Juan-Gg/Linear-lab-bench-power-supply/README.md

# Linear-lab-bench-power-supply
This is a dual channel linear lab power supply, each channel capable of 30 V at 500 mA.
More information here: https://juangg-projects.blogspot.com/2019/05/linear-lab-power-supply.html
