Juan-Gg/Linear-lab-bench-power-supply/Mechanical/PSU Render.JPG

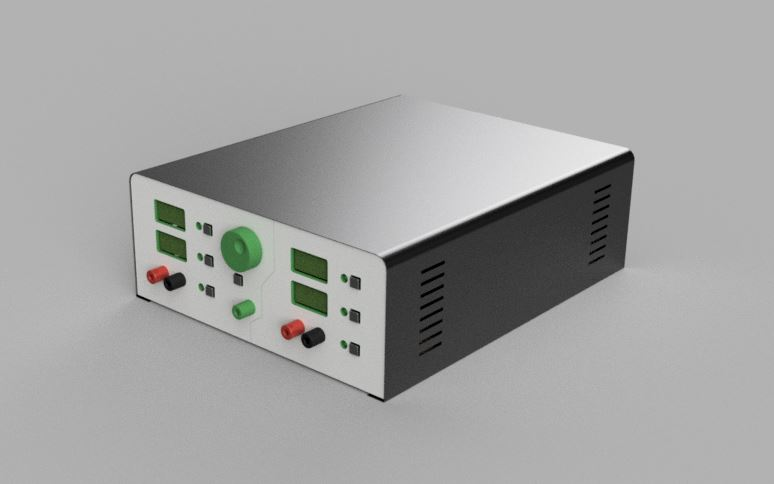
Mechanical/PSU Render.JPG
