Juan-Gg/Linear-lab-bench-power-supply/Mechanical/STLS/back_right.stl

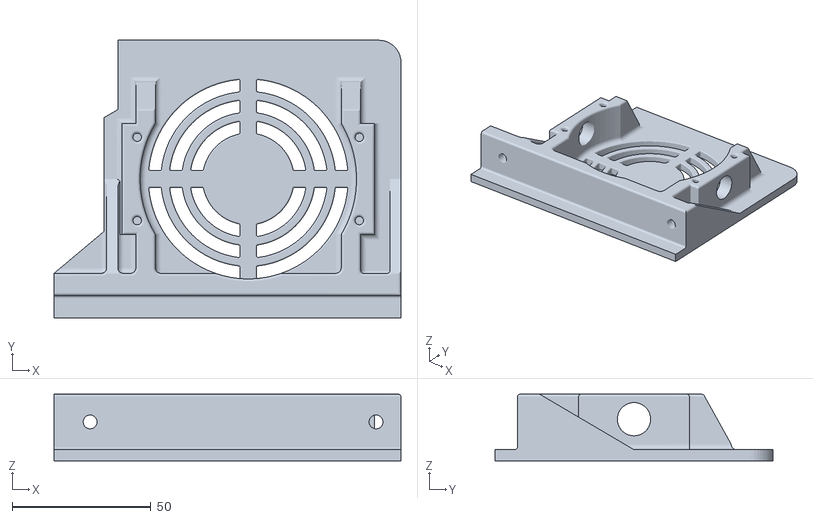
[picture p2: CAD file, 2019-05-11]
Mechanical/STLS/back_right.stl
125.0 x 100.0 x 24.0
