Juan-Gg/Linear-lab-bench-power-supply/Mechanical/STLS/knob.stl

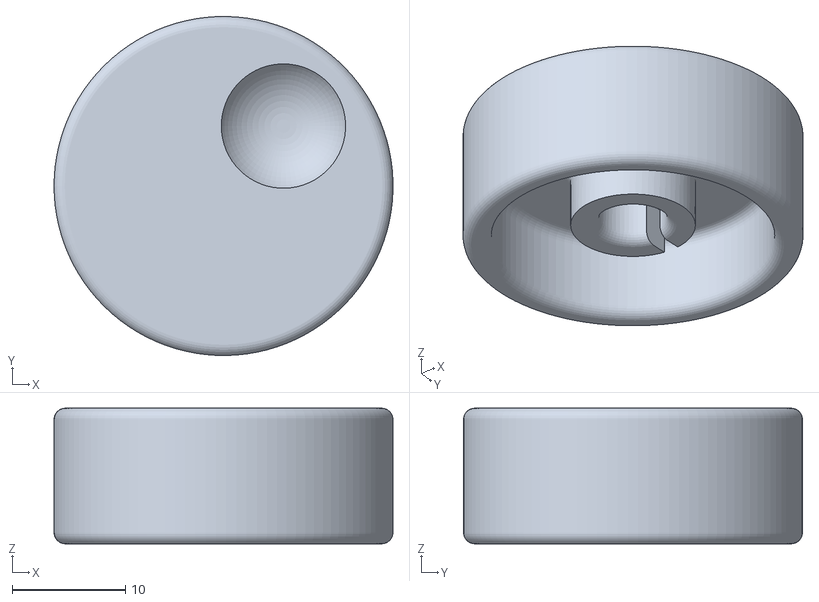
[picture p3: CAD file, 2019-05-11]
Mechanical/STLS/knob.stl
30.0 x 30.0 x 12.0
