Juan-Gg/Linear-lab-bench-power-supply/Mechanical/STLS/front_left.stl

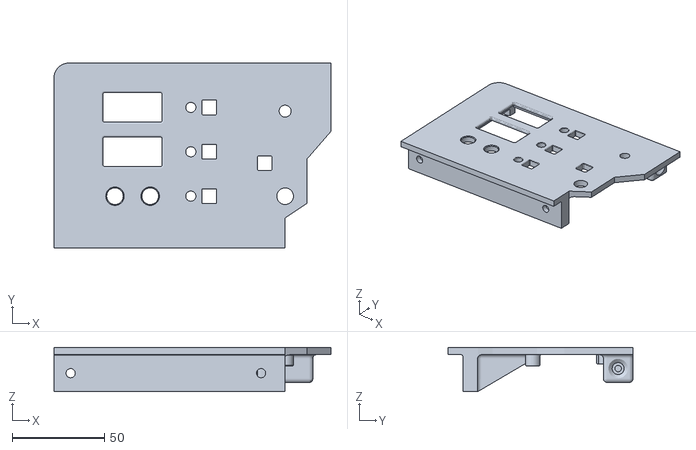
[picture p4: CAD file, 2019-05-11]
Mechanical/STLS/front_left.stl
149.8 x 100.0 x 24.0
