Juan-Gg/Linear-lab-bench-power-supply/Mechanical/STLS/back_left.stl

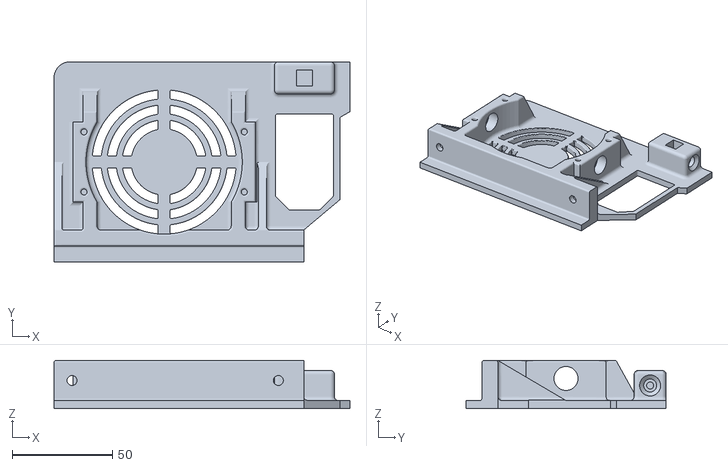
[picture p5: CAD file, 2019-05-11]
Mechanical/STLS/back_left.stl
147.8 x 100.0 x 24.0
