Juan-Gg/Linear-lab-bench-power-supply/Mechanical/STLS/btn.stl

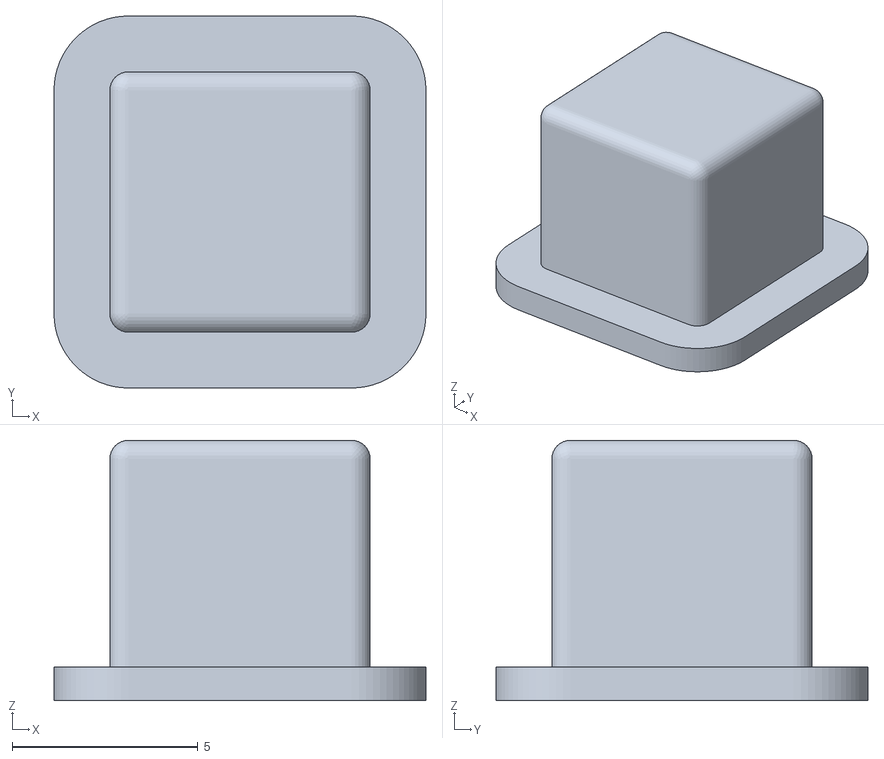
[picture p6: CAD file, 2019-05-11]
Mechanical/STLS/btn.stl
10.0 x 10.0 x 7.00
