Juan-Gg/Linear-lab-bench-power-supply/Mechanical/STLS/front_right.stl

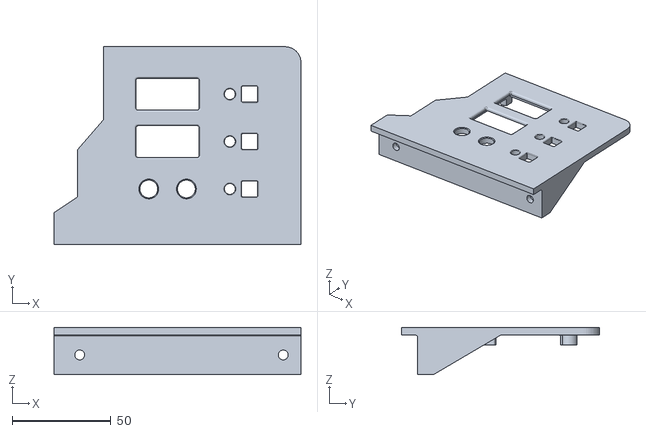
[picture p7: CAD file, 2019-05-11]
Mechanical/STLS/front_right.stl
125.0 x 100.0 x 24.0
