Juan-Gg/Linear-lab-bench-power-supply/Mechanical/STLS/PCB_mount.stl

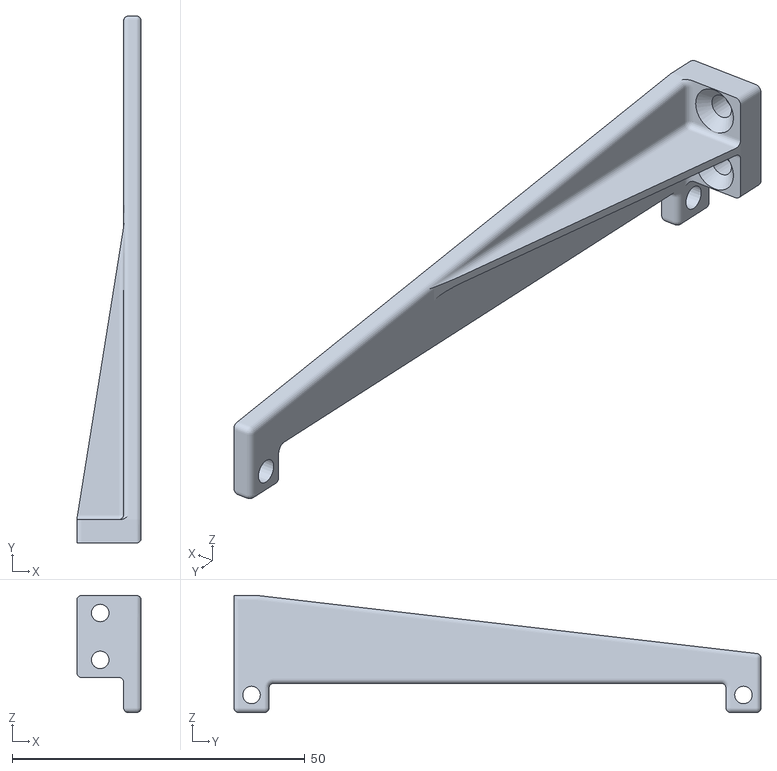
[picture p8: CAD file, 2019-05-11]
Mechanical/STLS/PCB_mount.stl
11.0 x 90.0 x 20.0
