Juan-Gg/Linear-lab-bench-power-supply/Electronics/RevBSchematics.pdf

## Q4 TIP35C

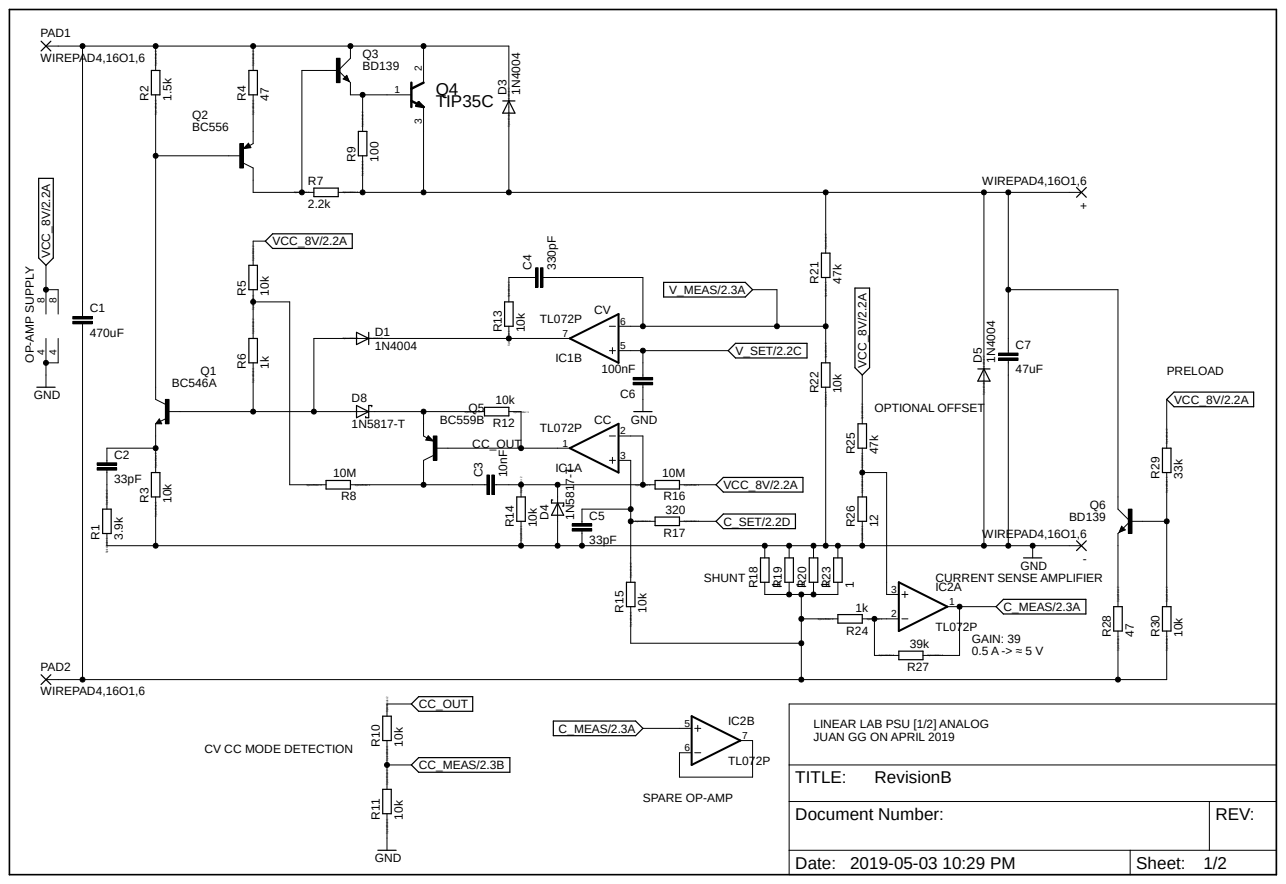
[picture p9: page 1]

CV CC MODE DETECTION OP⁻AMP SUPPLY

LINEAR LAB PSU [1/2] ANALOG
JUAN GG ON APRIL 2019

Document Number: | REV:

Date: 2019-05-03 10:29 PM | Sheet: 1/2

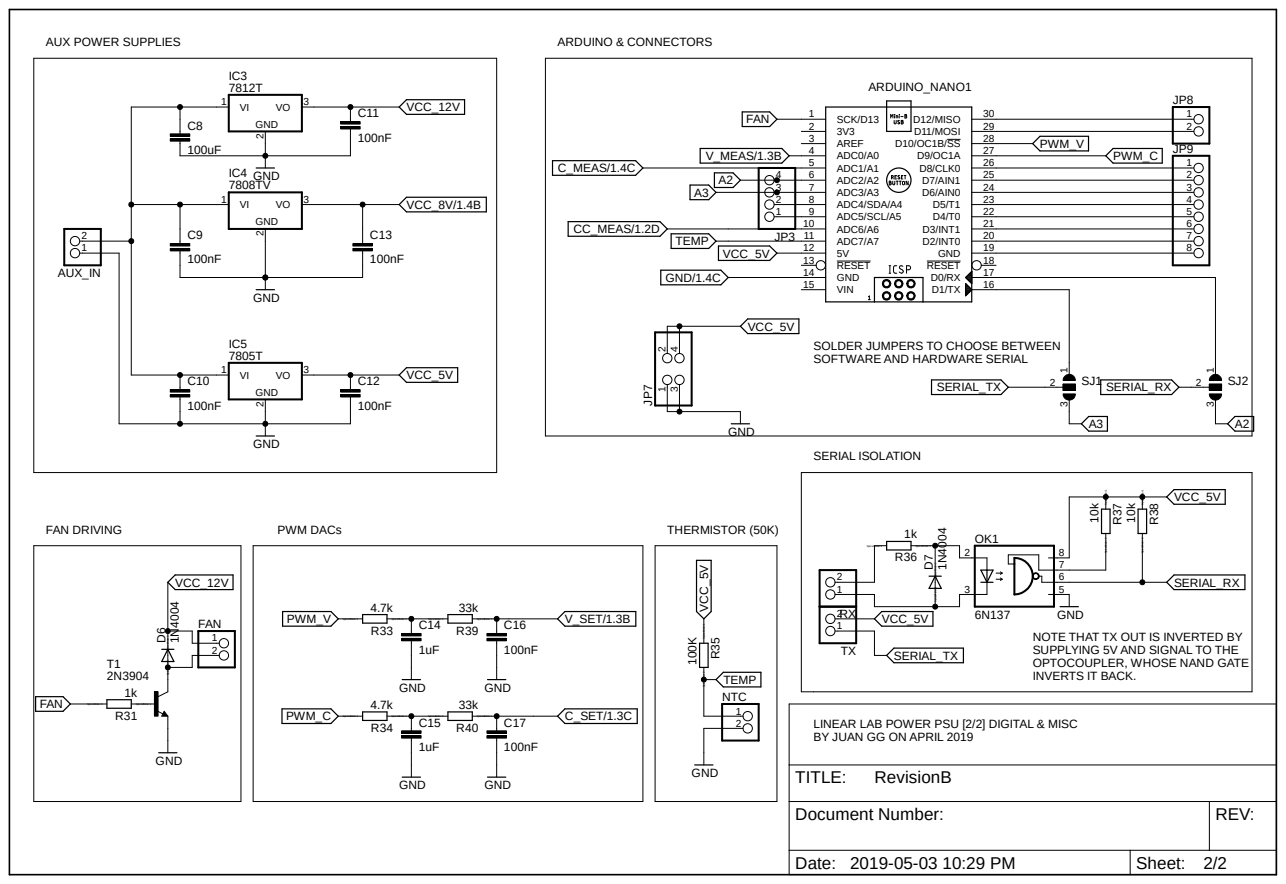
[picture p10: page 2]

ADC2/A2 6
3 | ADC3/A3 7

SOLDER JUMPERS TO CHOOSE BETWEEN
SOFTWARE AND HARDWARE SERIAL

NOTE THAT TX OUT IS INVERTED BY
SUPPLYING 5V AND SIGNAL TO THE
OPTOCOUPLER, WHOSE NAND GATE
INVERTS IT BACK.

LINEAR LAB POWER PSU [2/2] DIGITAL & MISC
BY JUAN GG ON APRIL 2019

Document Number: | REV:

Date: 2019-05-03 10:29 PM | Sheet: 2/2
