Juan-Gg/Linear-lab-bench-power-supply/Mechanical/Front panel overlay.pdf

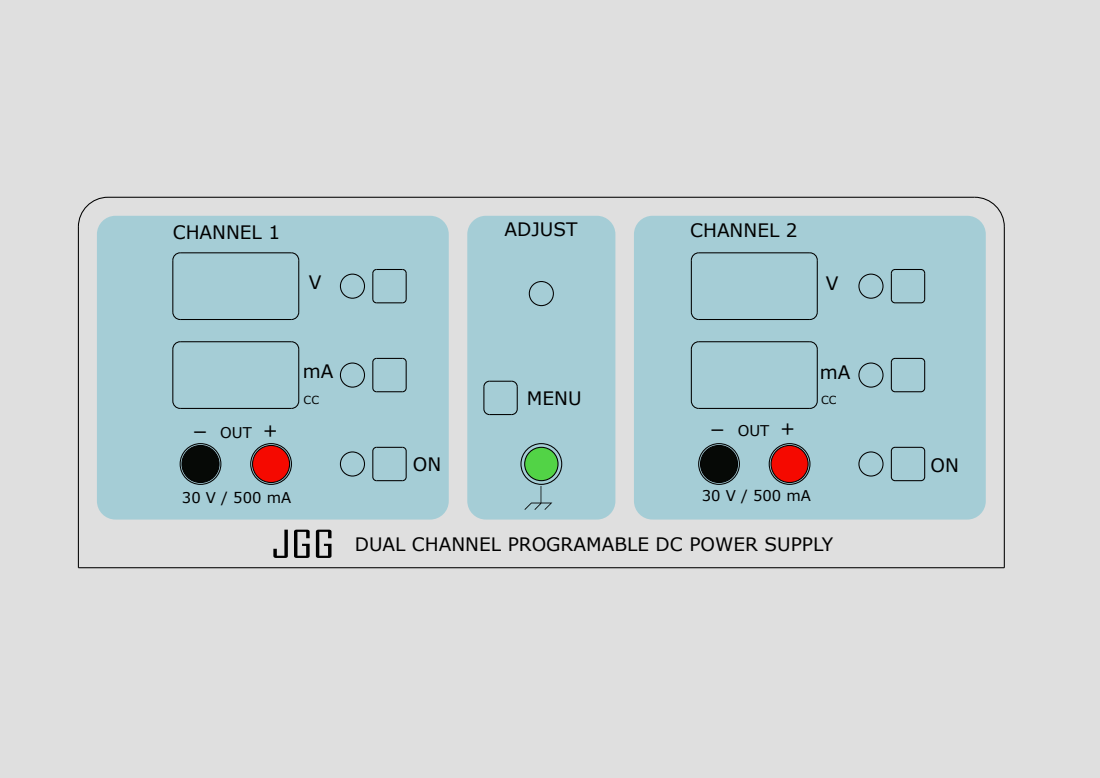
[picture p11: page 1]
CHANNEL 1; ADJUST; CHANNEL 2; OUT; MENU

JGG DUAL CHANNEL PROGRAMABLE DC POWER SUPPLY
