Juan-Gg/Linear-lab-bench-power-supply/Electronics/KeyboardSchematics.pdf

SLAVE (CH 1) | MASTER (CH 2)

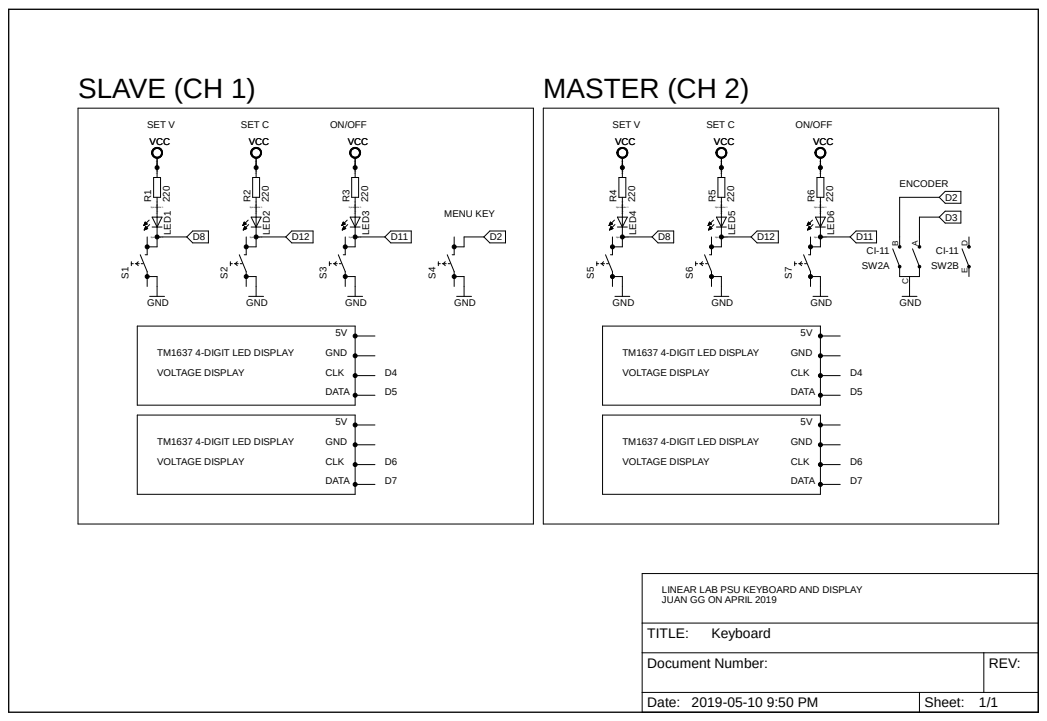
[picture p12: page 1]

LINEAR LAB PSU KEYBOARD AND DISPLAY
JUAN GG ON APRIL 2019

Document Number: | REV:

Date: 2019-05-10 9:50 PM | Sheet: 1/1
