Juan-Gg/Linear-lab-bench-power-supply/Electronics/RevABoardOverlay.pdf

+

# OUT

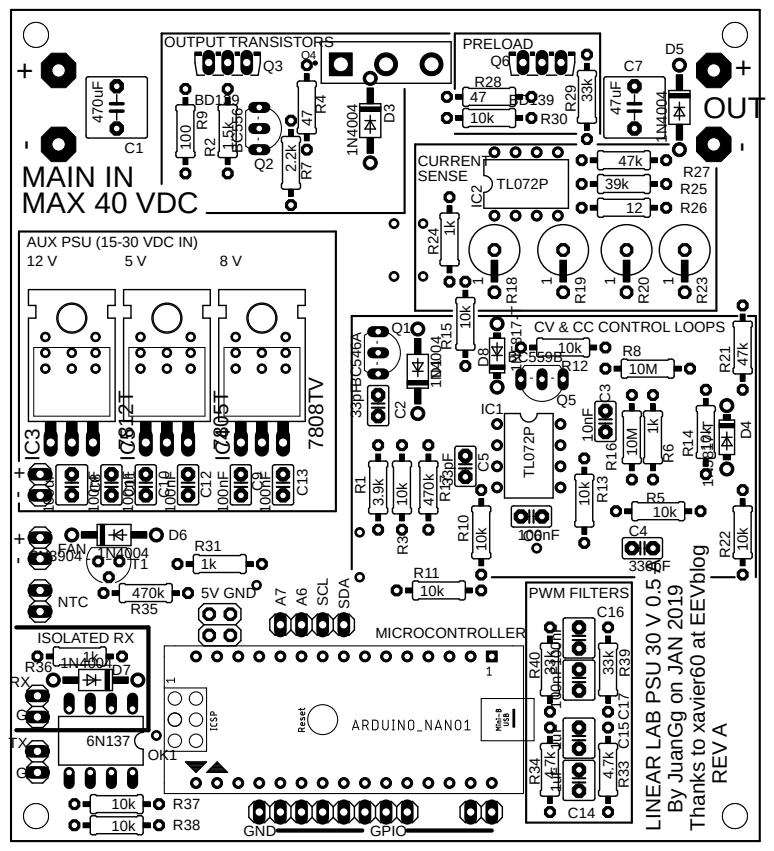
[picture p13: page 1]

OUTPUT TRANSISTORS
CV & CC CONTROL LOOPS LINEAR LAB PSU ³⁰ V ⁰.5 A By JuanGg on JAN ²⁰¹⁹ Thanks to xavier60 at EEVblog REV A

AUX PSU (15-30 VDC IN)
