Juan-Gg/Linear-lab-bench-power-supply/Electronics/RevASchematics.pdf

## Q4 TIP35C

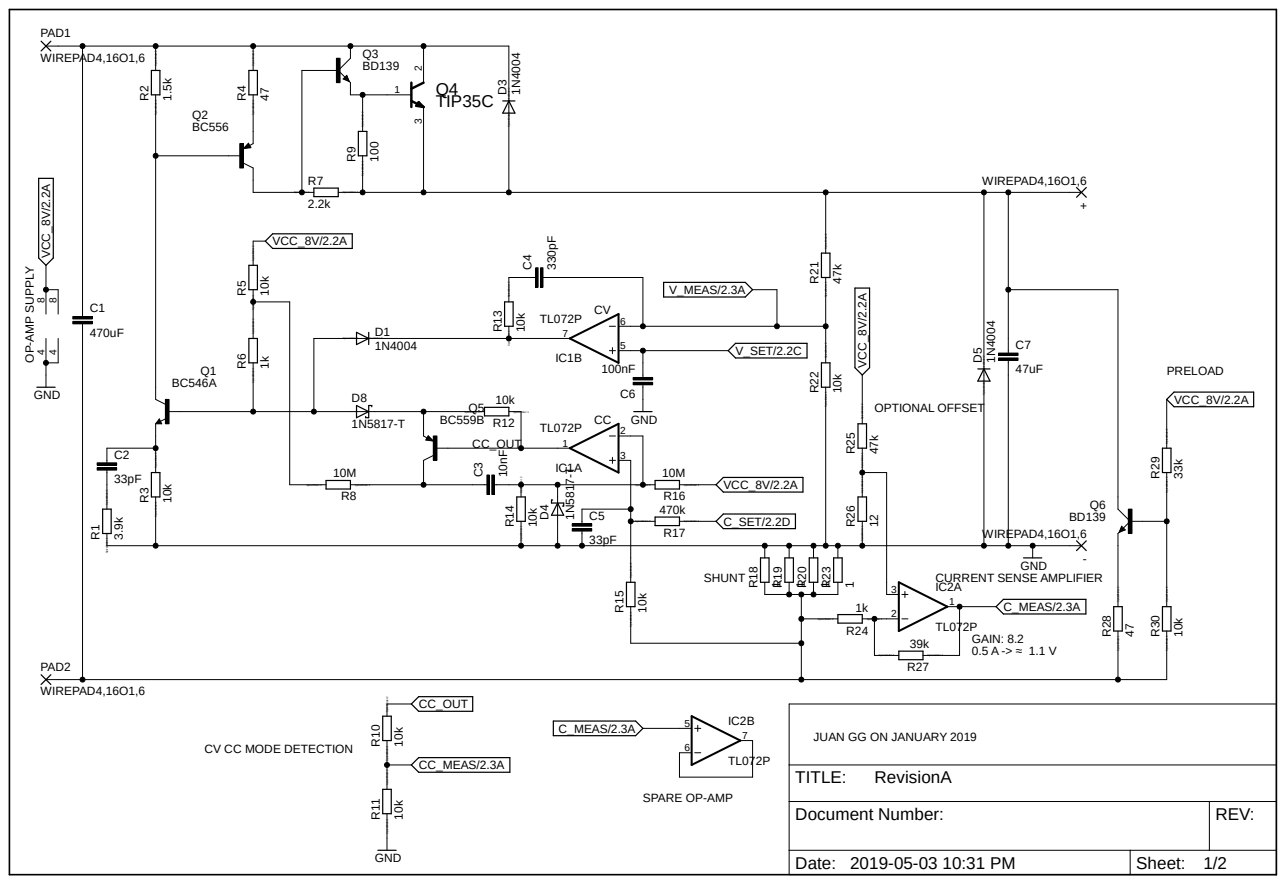
[picture p14: page 1]

CV CC MODE DETECTION OP⁻AMP SUPPLY

JUAN GG ON JANUARY 2019

Document Number: | REV:

Date: 2019-05-03 10:31 PM | Sheet: 1/2

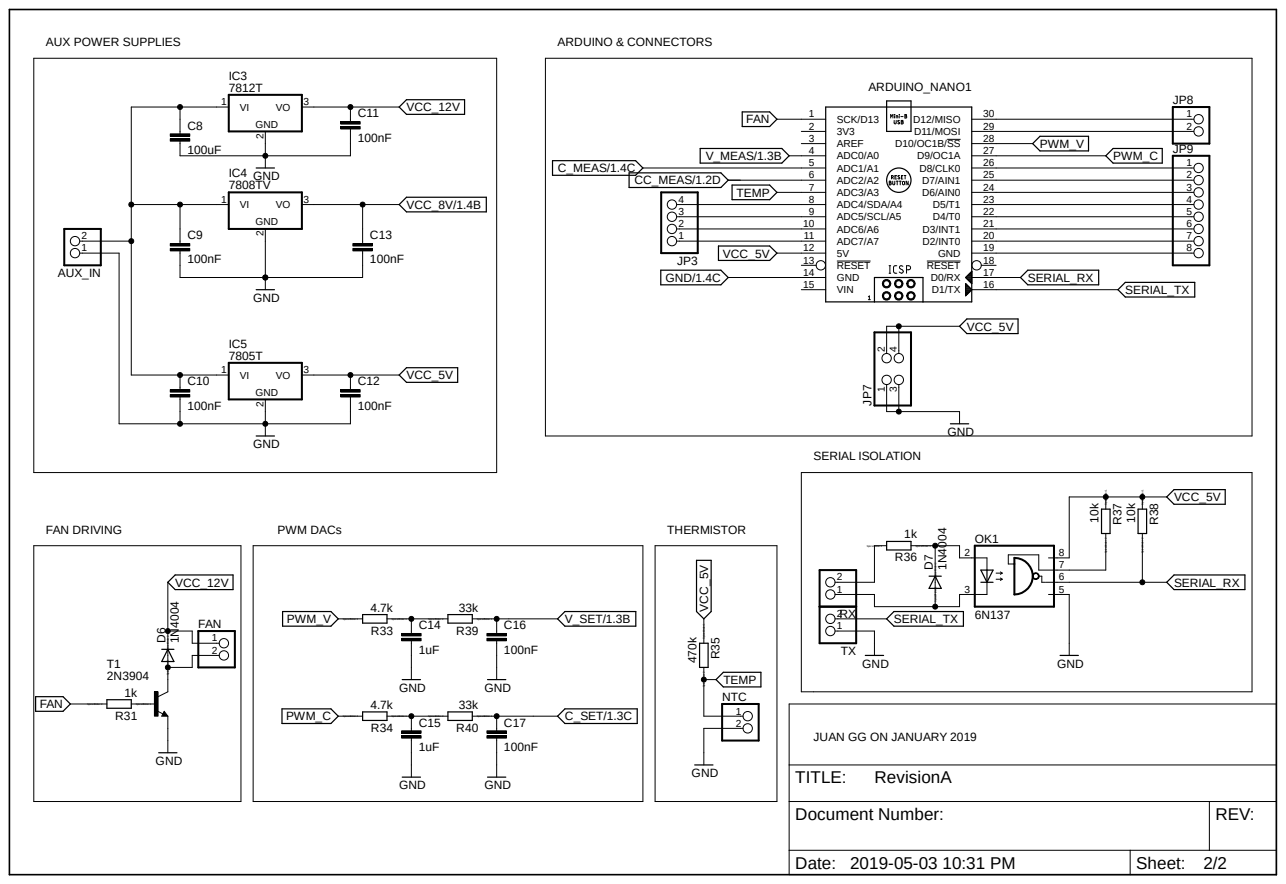
[picture p15: page 2]

JUAN GG ON JANUARY 2019

Document Number: | REV:

Date: 2019-05-03 10:31 PM | Sheet: 2/2
