Juan-Gg/Linear-lab-bench-power-supply/Electronics/RevBBoardOverlay.pdf

+

# OUT

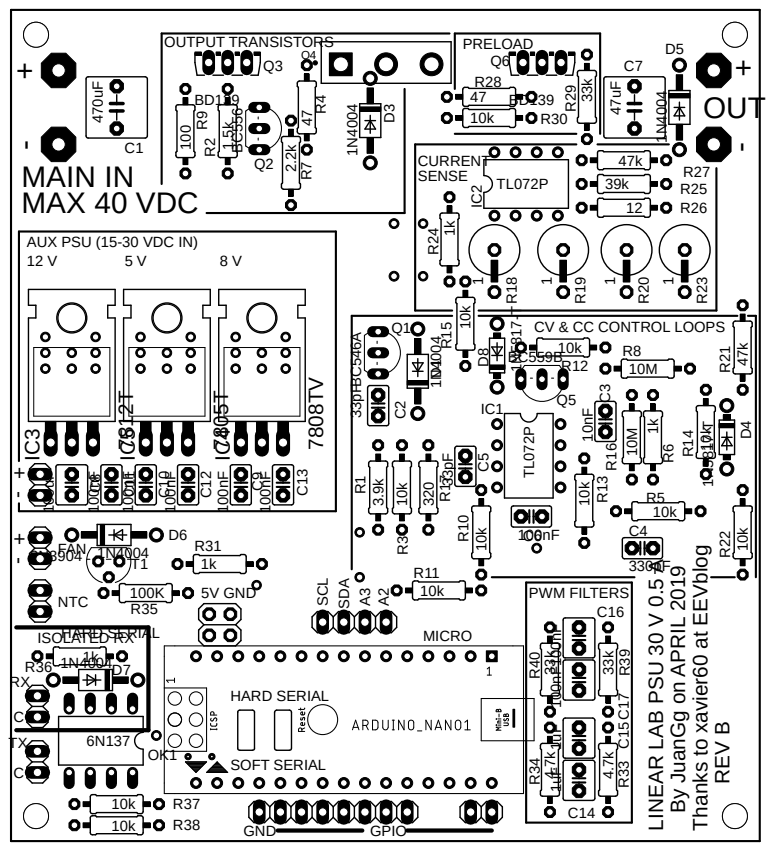
[picture p16: page 1]

AUX PSU (15-30 VDC IN)

CV & CC CONTROL LOOPS
