Juan-Gg/Linear-lab-bench-power-supply/Mechanical/Cover dimensions.pdf

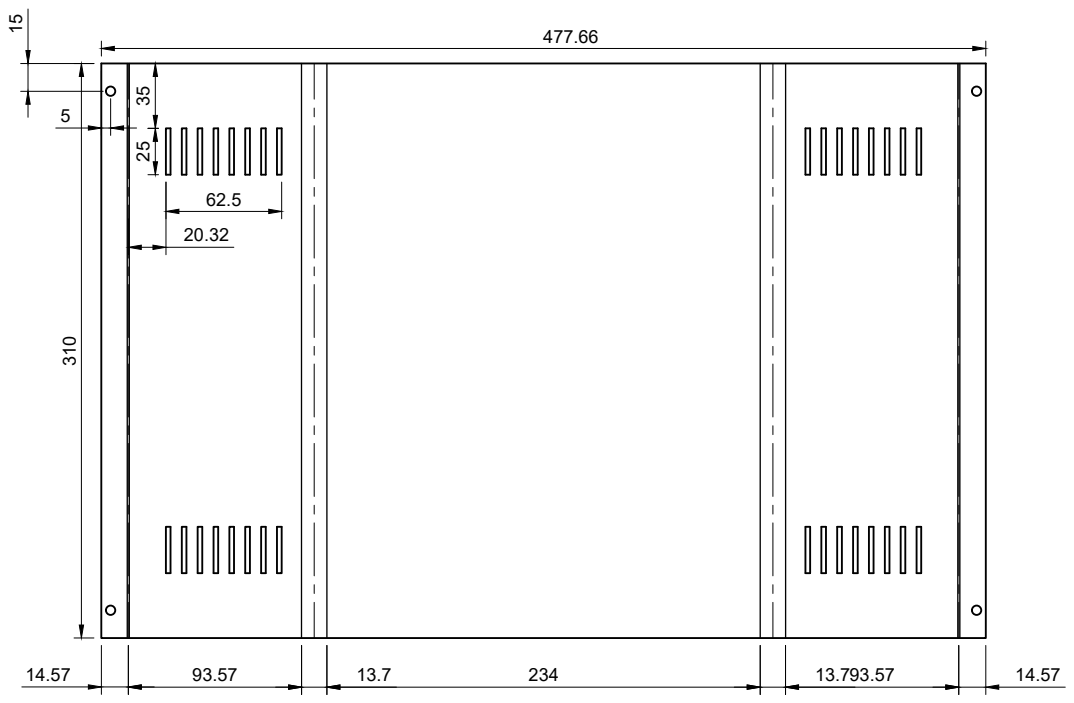
[picture p17: page 1]
