Juan-Gg/Linear-lab-bench-power-supply/Mechanical/Lab psu case drawing.pdf

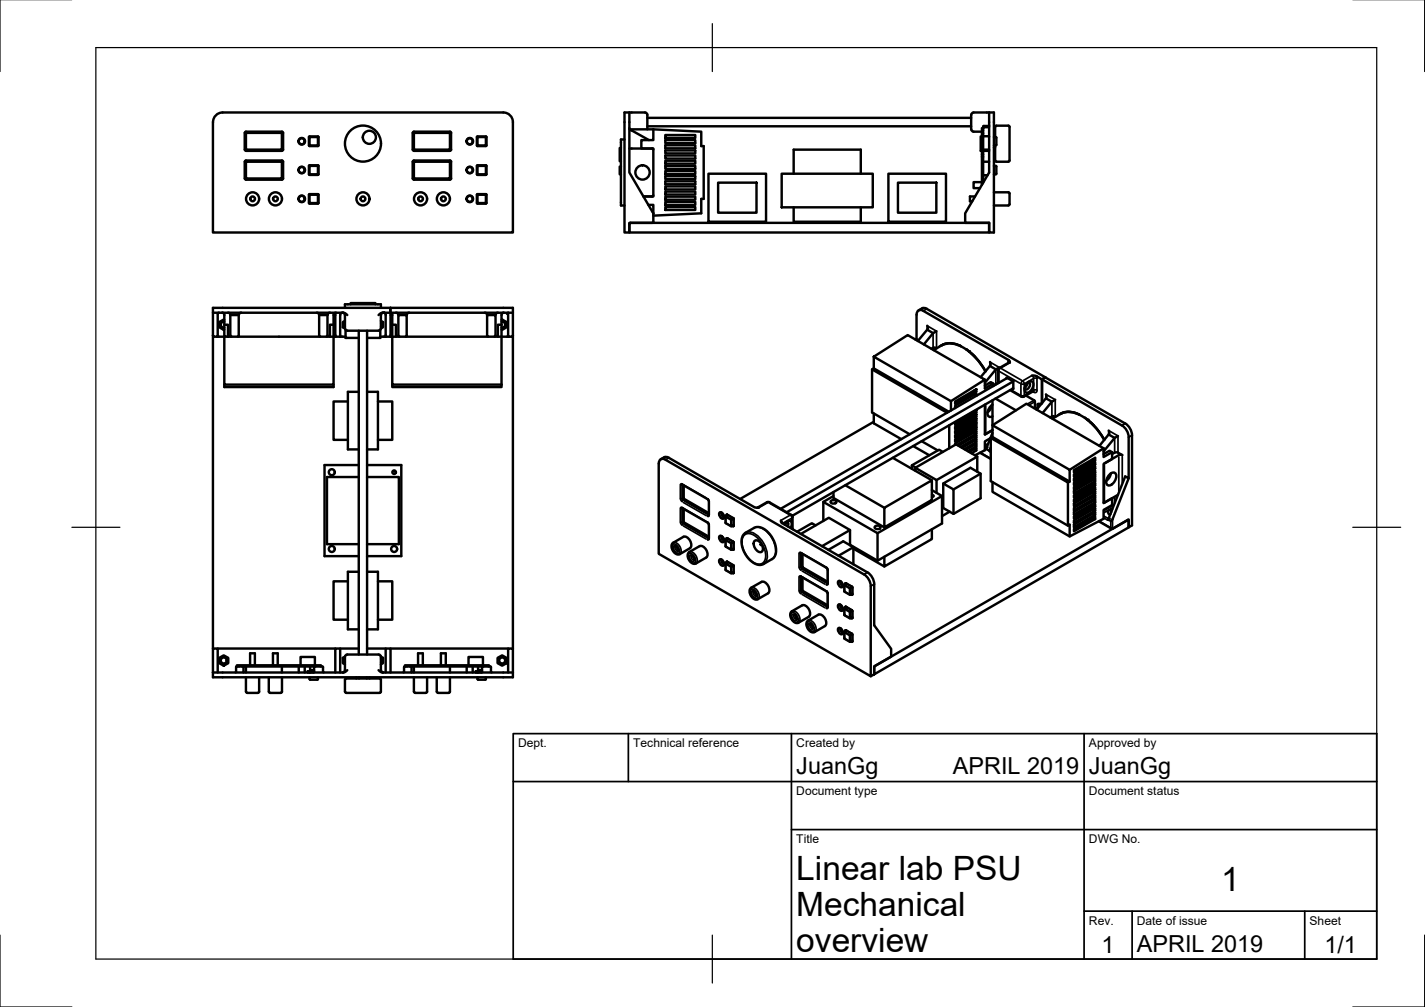
[picture p18: page 1]

Dept. | Technical reference | Created by JuanGg APRIL 2019 | Approved by JuanGg

Document type | Document status

Title Linear lab PSU Mechanical overview | DWG No. 1

Rev. 1 | Date of issue APRIL 2019 | Sheet 1/1
