Juan-Gg/Linear-lab-bench-power-supply/Electronics/RevisionA.brd

## EAGLE design Electronics/RevisionA.brd (2019-05-11, an earlier design)

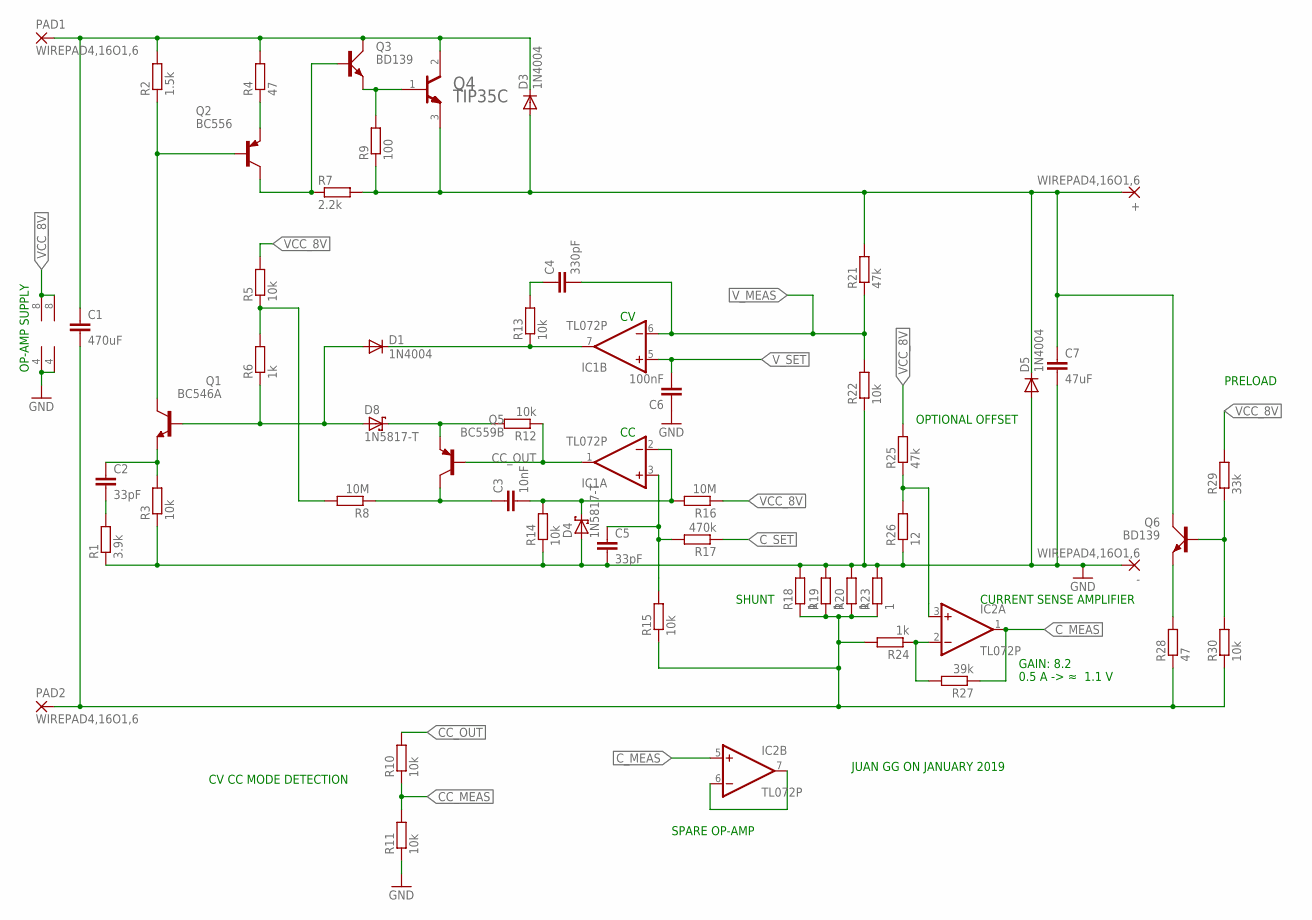
[picture p19: schematic RevisionA.sch, sheet 1]

Parts:
+: WIREPAD4,16O1,6; 4,16O1,6
-: WIREPAD4,16O1,6; 4,16O1,6
C1: 470uF; C5B7.2
C2, C5: 33pF; C2.5-2
C3: 10nF; C2.5-2
C4: 330pF; C2.5-2
C6: 100nF; C2.5-2
C7: 47uF; C5B7.2
D1, D3, D5: 1N4004; DO41-10
D4, D8: 1N5817-T; DO41-7.6
IC1, IC2: TL072P; DIL08
PAD1, PAD2: WIREPAD4,16O1,6; 4,16O1,6
Q1: BC546A; TO92-EBC
Q2: BC556; TO92-EBC
Q3, Q6: BD139; TO126AV
Q4: STMICROELECTRONICS_TIP35CSTMICROELECTRONICS_TIP35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; STMICROELECTRONICS_TIP35C_0
Q5: BC559B; TO92-EBC
R1: 3.9k; 0207/10
R2: 1.5k; 0207/10
R3, R5, R10, R11, R12, R13, R14, R15, R22, R30: 10k; 0207/10
R4, R28: 47; 0207/10
R6, R24: 1k; 0207/10
R7: 2.2k; 0207/10
R8, R16: 10M; 0207/10
R9: 100; 0207/10
R17: 470k; 0207/10
R18, R19, R20, R23: 1; 0617V
R21, R25: 47k; 0207/10
R26: 12; 0207/10
R27: 39k; 0207/10
R29: 33k; 0207/10

Connections:
+UNREG(MAIN): C1.1, D3.C, PAD1.1, Q3.C, Q4.2 (COLLECTOR), R2.2, R4.2
-UNREG(MAIN): C1.2, PAD2.1, R15.1, R18.1, R19.1, R20.1, R23.1, R24.2, R28.1, R30.1
CC_MEAS: R10.1, R11.2; also elsewhere on the board
CC_OUT: IC1.1 (OUT), Q5.B, R10.2, R12.1
C_MEAS: IC2.1 (OUT), IC2.5 (+IN), R27.1; also elsewhere on the board
C_SET: R17.1; also elsewhere on the board
GND: -.1, C5.2, C6.1, C7.2, D4.A, D5.A, IC1.4 (V-), IC2.4 (V-), R1.1, R3.1, R11.1, R14.1, R18.2, R19.2, R20.2, R22.1, R23.2, R26.1; also elsewhere on the board
unnamed: Q3.E, Q4.1 (BASE), R9.2
unnamed: +.1, C7.1, D3.A, D5.C, Q4.3 (EMITTER), Q6.C, R7.2, R9.1, R21.2
unnamed: Q2.C, Q3.B, R7.1
unnamed: Q2.E, R4.1
unnamed: Q1.C, Q2.B, R2.1
unnamed: R5.1, R6.2, R8.2
unnamed: D1.A, D8.A, Q1.B, R6.1
unnamed: C2.1, Q1.E, R3.2
unnamed: C2.2, R1.2
unnamed: D8.C, Q5.E, R12.2
unnamed: C3.2, D4.C, IC1.2 (-IN), R14.2, R16.2
unnamed: C3.1, Q5.C, R8.1
unnamed: C5.1, IC1.3 (+IN), R15.2, R17.2
unnamed: D1.C, IC1.7 (OUT), R13.1
unnamed: C4.1, R13.2
unnamed: Q6.E, R28.2
unnamed: Q6.B, R29.1, R30.2
unnamed: IC2.2 (-IN), R24.1, R27.2
unnamed: IC2.6 (-IN), IC2.7 (OUT)
unnamed: IC2.3 (+IN), R25.1, R26.2
VCC_8V: IC1.8 (V+), IC2.8 (V+), R5.2, R16.1, R25.2, R29.2; also elsewhere on the board
V_MEAS: C4.2, IC1.6 (-IN), R21.1, R22.2; also elsewhere on the board
V_SET: C6.2, IC1.5 (+IN); also elsewhere on the board

Notes on the sheet:
GAIN: 8.2
OPTIONAL OFFSET
SPARE OP-AMP
0.5 A -> ≈ 1.1 V
PRELOAD
CV CC MODE DETECTION
OP-AMP SUPPLY
CURRENT SENSE AMPLIFIER
SHUNT
JUAN GG ON JANUARY 2019

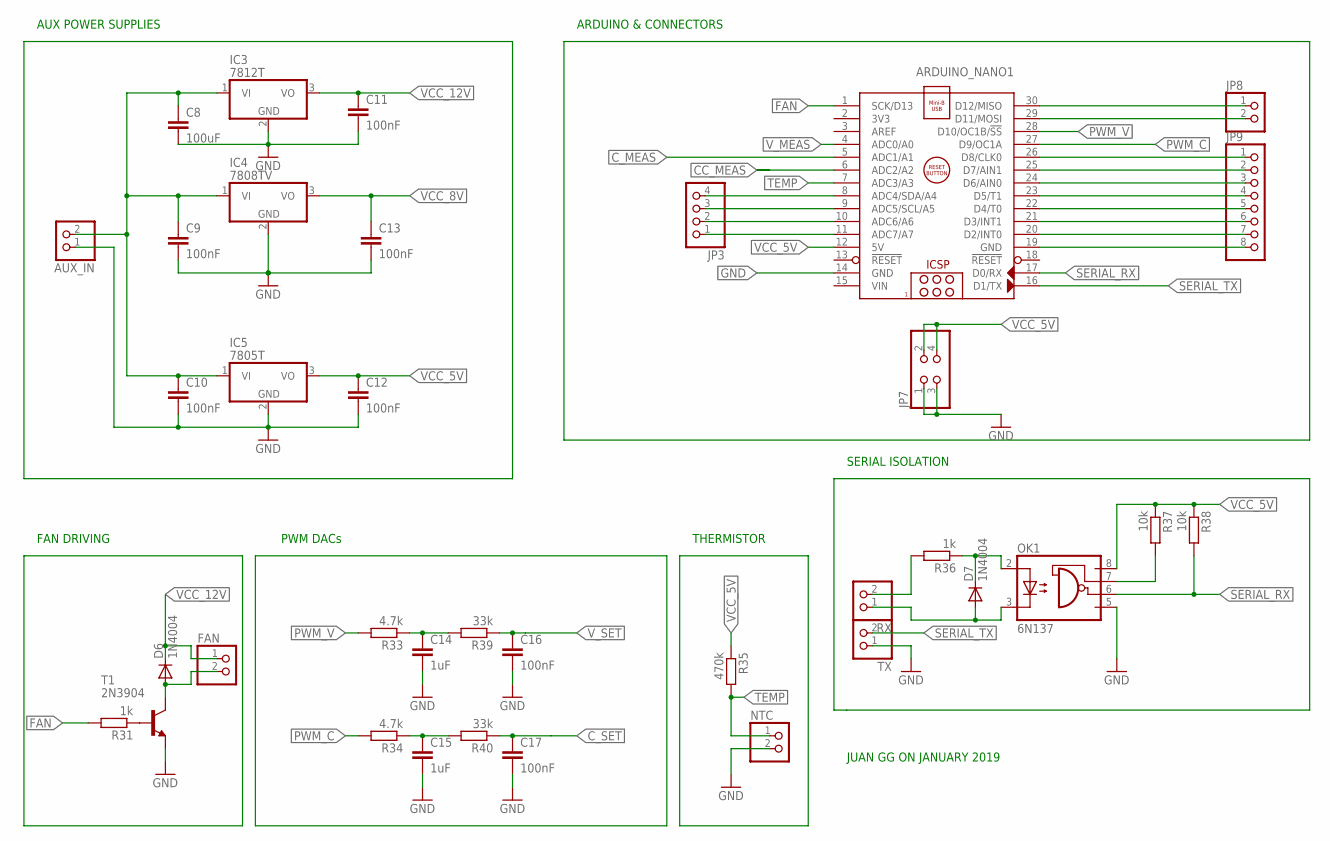
[picture p20: schematic RevisionA.sch, sheet 2]

Parts:
ARDUINO_NANO1: ARDUINO_NANO
AUX_IN: PINHD-1X2; 1X02
C8: 100uF; C2.5-4
C9, C10, C11, C12, C13: 100nF; C2.5-2
C14, C15: 1uF; C2.5-4
C16, C17: 100nF; C2.5-4
D6, D7: 1N4004; DO41-10
FAN: PINHD-1X2; 1X02
IC3: 7812T; TO220H
IC4: 7808TV; TO220H
IC5: 7805T; TO220H
JP3: PINHD-1X4; 1X04
JP7: PINHD-2X2; 2X02
JP8: PINHD-1X2; 1X02
JP9: PINHD-1X8; 1X08
NTC: PINHD-1X2; 1X02
OK1: 6N137; DIL08
R31, R36: 1k; 0207/10
R33, R34: 4.7k; 0207/10
R35: 470k; 0207/10
R37, R38: 10k; 0207/10
R39, R40: 33k; 0207/10
RX: PINHD-1X2; 1X02
T1: 2N3904; TO92
TX: PINHD-1X2; 1X02

Connections:
+UNREG(AUX): AUX_IN.2, C8.1, C9.1, C10.1, IC3.1 (VI), IC4.1 (VI), IC5.1 (VI)
A6: ARDUINO_NANO1.10 (ADC6/A6), JP3.2
A7: ARDUINO_NANO1.11 (ADC7/A7), JP3.1
CC_MEAS: ARDUINO_NANO1.6 (ADC2/A2); also elsewhere on the board
C_MEAS: ARDUINO_NANO1.5 (ADC1/A1); also elsewhere on the board
C_SET: C17.1, R40.1; also elsewhere on the board
D2: ARDUINO_NANO1.20 (D2/INT0), JP9.7
D3: ARDUINO_NANO1.21 (D3/INT1), JP9.6
D4: ARDUINO_NANO1.22 (D4/T0), JP9.5
D5: ARDUINO_NANO1.23 (D5/T1), JP9.4
D6: ARDUINO_NANO1.24 (D6/AIN0), JP9.3
D7: ARDUINO_NANO1.25 (D7/AIN1), JP9.2
D8: ARDUINO_NANO1.26 (D8/CLK0), JP9.1
D11: ARDUINO_NANO1.29 (D11/MOSI), JP8.2
D12: ARDUINO_NANO1.30 (D12/MISO), JP8.1
FAN: ARDUINO_NANO1.1 (SCK/D13), R31.2
GND: ARDUINO_NANO1.14 (GND), ARDUINO_NANO1.19 (GND), AUX_IN.1, C8.2, C9.2, C10.2, C11.2, C12.2, C13.2, C14.2, C15.2, C16.2, C17.2, IC3.2 (GND), IC4.2 (GND), IC5.2 (GND), JP7.1, JP7.3, JP9.8, NTC.2, OK1.5 (GND), T1.3 (E), TX.1; also elsewhere on the board
unnamed: D7.C, OK1.2 (A), R36.1
unnamed: C14.1, R33.1, R39.2
unnamed: OK1.7 (VE), R37.2
unnamed: D6.A, FAN.2, T1.1 (C)
unnamed: R31.1, T1.2 (B)
unnamed: C15.1, R34.1, R40.2
unnamed: R36.2, RX.2
unnamed: D7.A, OK1.3 (C), RX.1
unnamed: ARDUINO_NANO1.8 (ADC4/SDA/A4), JP3.4
unnamed: ARDUINO_NANO1.9 (ADC5/SCL/A5), JP3.3
PWM_C: ARDUINO_NANO1.27 (D9/OC1A), R34.2
PWM_V: ARDUINO_NANO1.28 (D10/OC1B/!SS), R33.2
SERIAL_RX: ARDUINO_NANO1.17 (D0/RX), OK1.6 (VO), R38.2
SERIAL_TX: ARDUINO_NANO1.16 (D1/TX), TX.2
TEMP: ARDUINO_NANO1.7 (ADC3/A3), NTC.1, R35.2
VCC_5V: ARDUINO_NANO1.12 (5V), C12.1, IC5.3 (VO), JP7.2, JP7.4, OK1.8 (VCC), R35.1, R37.1, R38.1
VCC_8V: C13.1, IC4.3 (VO); also elsewhere on the board
VCC_12V: C11.1, D6.C, FAN.1, IC3.3 (VO)
VIN: ARDUINO_NANO1.15 (VIN)
V_MEAS: ARDUINO_NANO1.4 (ADC0/A0); also elsewhere on the board
V_SET: C16.1, R39.1; also elsewhere on the board

Notes on the sheet:
AUX POWER SUPPLIES
FAN DRIVING
PWM DACs
SERIAL ISOLATION
THERMISTOR
ARDUINO & CONNECTORS
JUAN GG ON JANUARY 2019

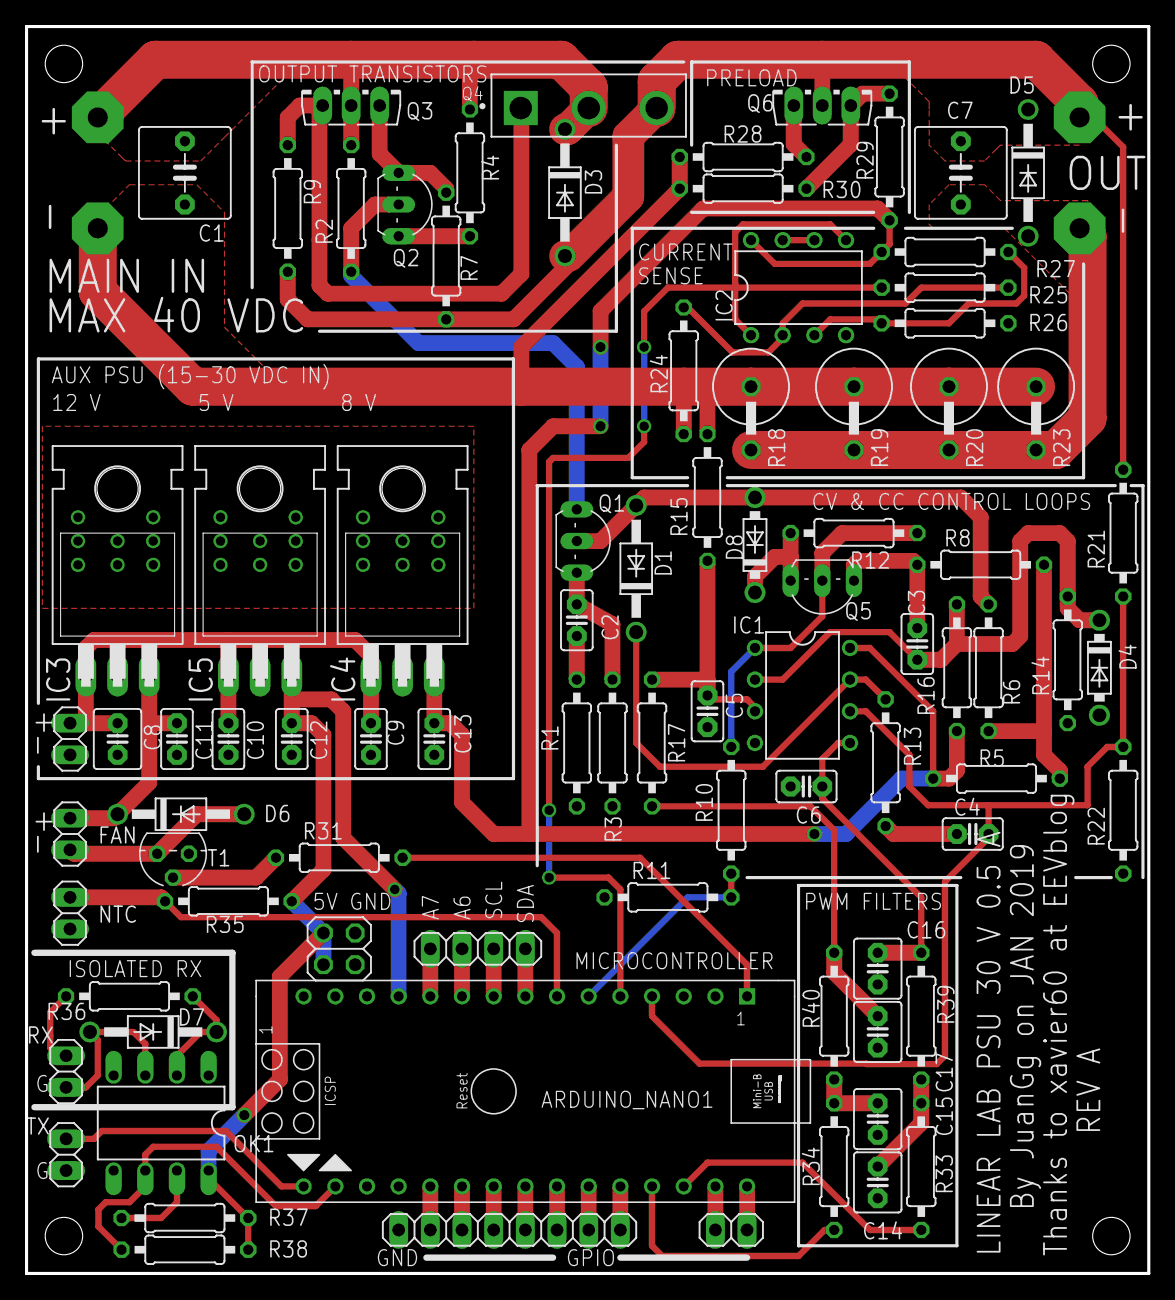
[picture p21: board RevisionA.brd from above]

Board: 2 copper layers, 90.0 x 100.0 mm, 90 parts (0 on the bottom side), 60 nets.
